openenergymonitor/emonWiFi/models/Same_Sky_UJ20-C-H-G-SMT-5-P16-TR.step

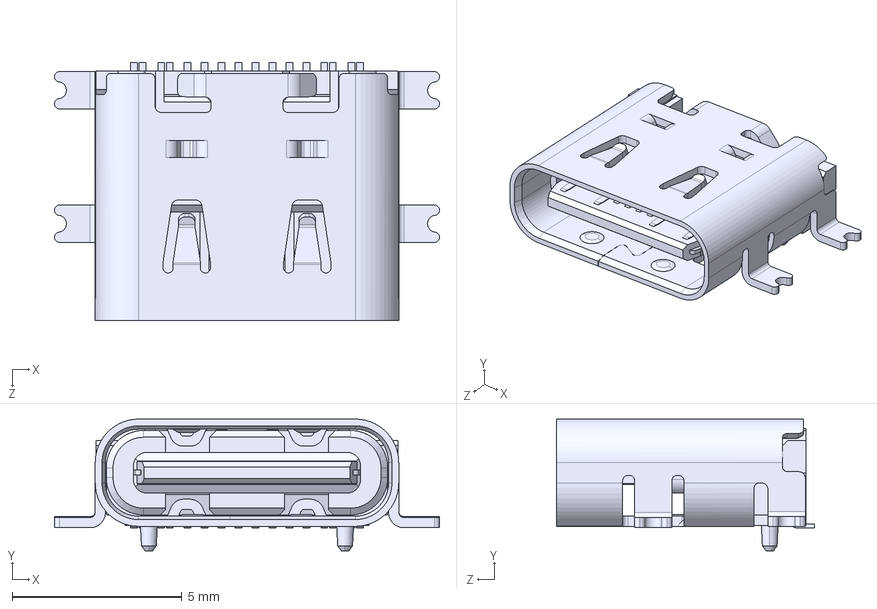
[picture p4: CAD file, 2026-04-18]
models/Same_Sky_UJ20-C-H-G-SMT-5-P16-TR.step
11.3 x 3.89 x 7.60 mm
