openenergymonitor/emonWiFi/CHANGELOG.md

# emonWiFi Changelog

## v1.1 -> v1.2

- [x] Fully surface mount USB-C socket

## v1.0 -> v1.1

- [x] Correct Rx/Tx for emonPi2/Pi3
- [x] Add 5.1 KΩ USB-PD negotiation resistors
- [x] Add switch for bootloader entry
- [x] Add informational silkscreen
