openenergymonitor/emonWiFi/(commit log)

2025-07-06 v1.0 candidate for Tx4/Tx5/Pi2++
    [emonWiFi.kicad_pcb, emonWiFi.kicad_sch]
2025-07-08 * Boot configuration
    - Add RC 1 ms on EN (10 K || 100 nF)
    - Add pull up on GPIO2
    [emonWiFi.kicad_pcb, emonWiFi.kicad_sch]
2025-07-29 Manufactured board
    [emonWiFi.kicad_pcb]
2026-01-03 Freeze for manufacture
    [emonWiFi.kicad_pcb, emonWiFi.kicad_sch]
